primatara42/Sistem-Monitoring-dan-Peringatan-Penggunaan-Air-PDAM-yang-Berlebihan-Berbasis-IoT/Foto Alat/Tampilan Debit dan Volume di LCD.png

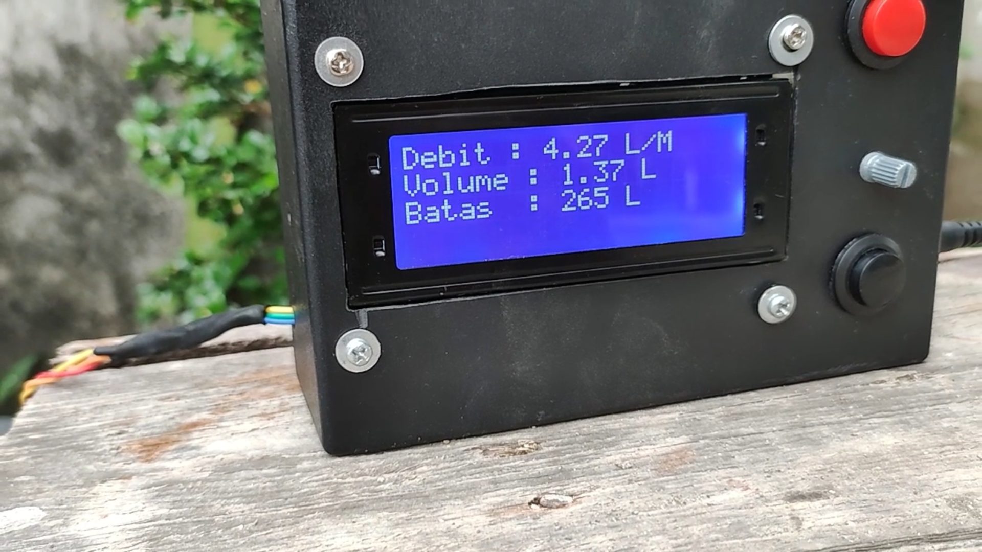
Foto Alat/Tampilan Debit dan Volume di LCD.png
