primatara42/Sistem-Monitoring-dan-Peringatan-Penggunaan-Air-PDAM-yang-Berlebihan-Berbasis-IoT/Foto Alat/Tampilan Utama LCD.jpeg

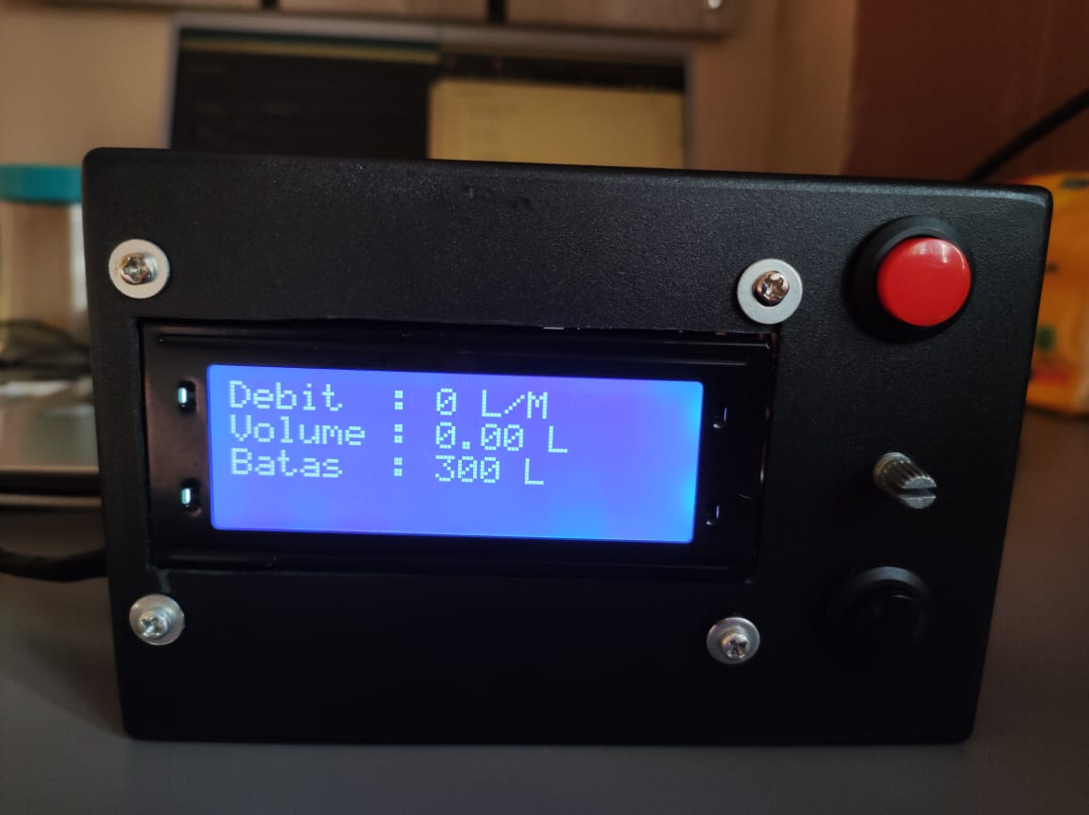
Foto Alat/Tampilan Utama LCD.jpeg
