primatara42/Sistem-Monitoring-dan-Peringatan-Penggunaan-Air-PDAM-yang-Berlebihan-Berbasis-IoT/README.md

# Sistem-Monitoring-dan-Peringatan-Penggunaan-Air-PDAM-yang-Berlebihan-Berbasis-IoT

Repo ini adalah hasil dari perancangan sebuah sistem untuk melakukan monitoring dan peringatan penggunaan air PDAM yang berlebihan berbasis 
Internet of Things.Sistem pada alat ini menggunakan NodeMCU ESP8266 sebagai mikrokontroler dan sensor water flow tipe YF-S201 yang mampu 
mengukur air dengan debit air sampai 30L/menit. 

Projek ini juga merupakan hasil dari Tugas Akhir yang saya kerjakan di tahun 2022 silam yang berjudul 
"PURWARUPA SISTEM MONITORING DAN PERINGATAN JUMLAH PEMAKAIAN AIR PDAM YANG BERLEBIHAN BERBASIS INTERNET OF THINGS" yang dibuat ketika 
saya masih menjadi mahasiswa di Universitas Sriwijaya Prodi D3 Teknik Komputer.

# Source Code dan Video Demonstrasi

- Source Code 		: https://drive.google.com/file/d/1m7pmJasBFbph-oy889h06VDKU2a7lw-W/view?usp=share_link

- Video Demonstrasi	: https://drive.google.com/file/d/1O1SfZqUQQt9ZpCXQGNGJgJtU_IBpunmK/view?usp=share_link
