primatara42/Sistem-Monitoring-dan-Peringatan-Penggunaan-Air-PDAM-yang-Berlebihan-Berbasis-IoT/Foto Alat/Tampilan Aplikasi Blynk.jpg

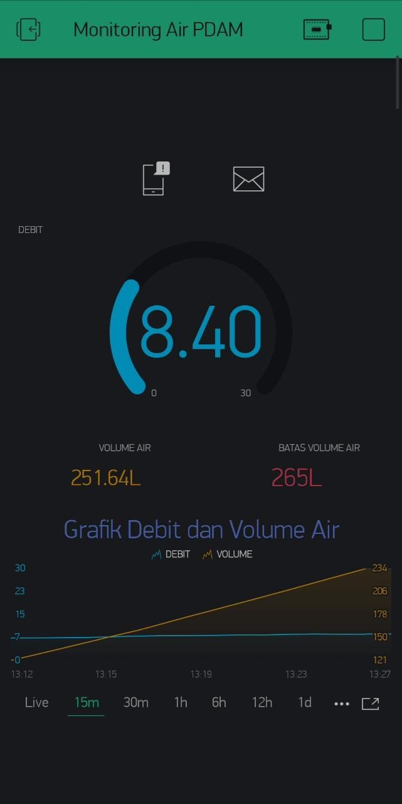
Foto Alat/Tampilan Aplikasi Blynk.jpg
