primatara42/Sistem-Monitoring-dan-Peringatan-Penggunaan-Air-PDAM-yang-Berlebihan-Berbasis-IoT/Foto Alat/Tampilan Depan Alat.jpg

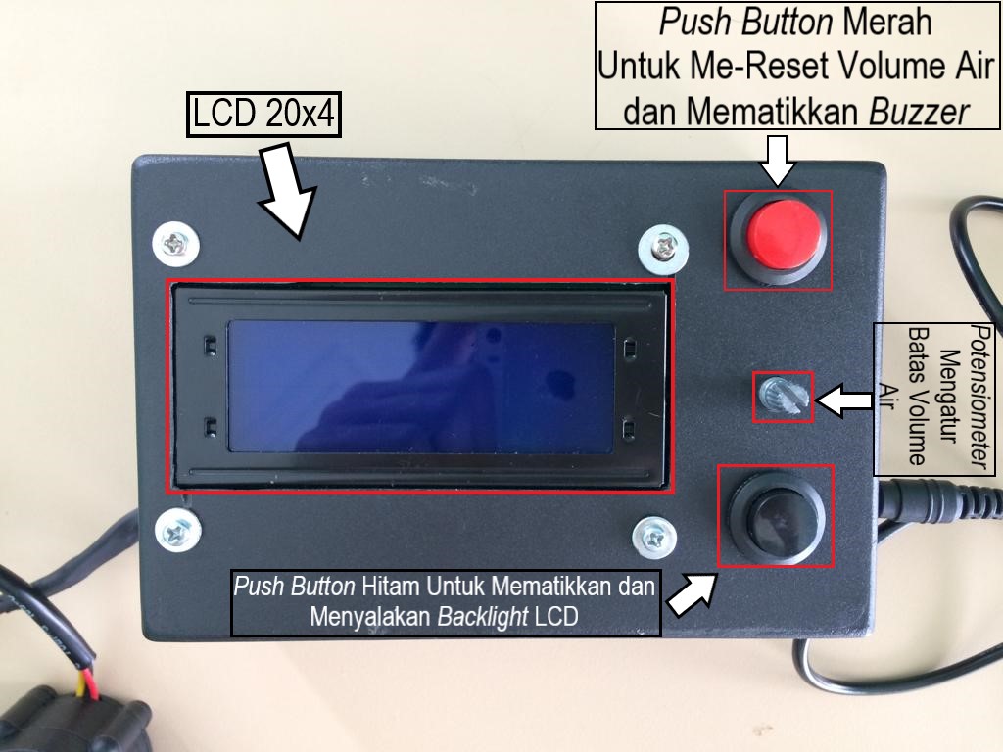
Foto Alat/Tampilan Depan Alat.jpg
