primatara42/Sistem-Monitoring-dan-Peringatan-Penggunaan-Air-PDAM-yang-Berlebihan-Berbasis-IoT/Foto Alat/Tampilan Notifikasi Ketika Sistem Peringatan Aktif.jpg

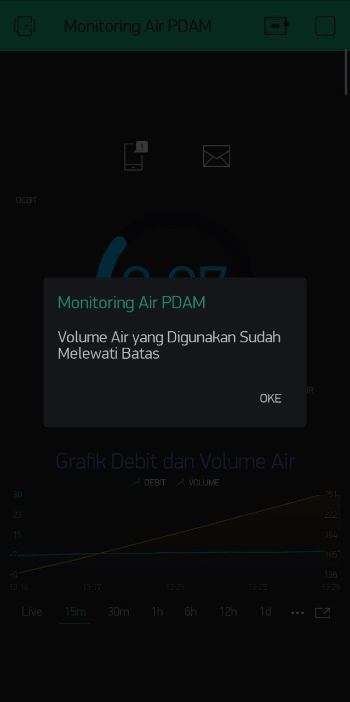
Foto Alat/Tampilan Notifikasi Ketika Sistem Peringatan Aktif.jpg
